Open-Laboratory/safeduino_mega_2560/kicad/safeduino_mega_2560.kicad_pcb

## KiCad design kicad/safeduino_mega_2560.kicad_pcb (2023-12-26)

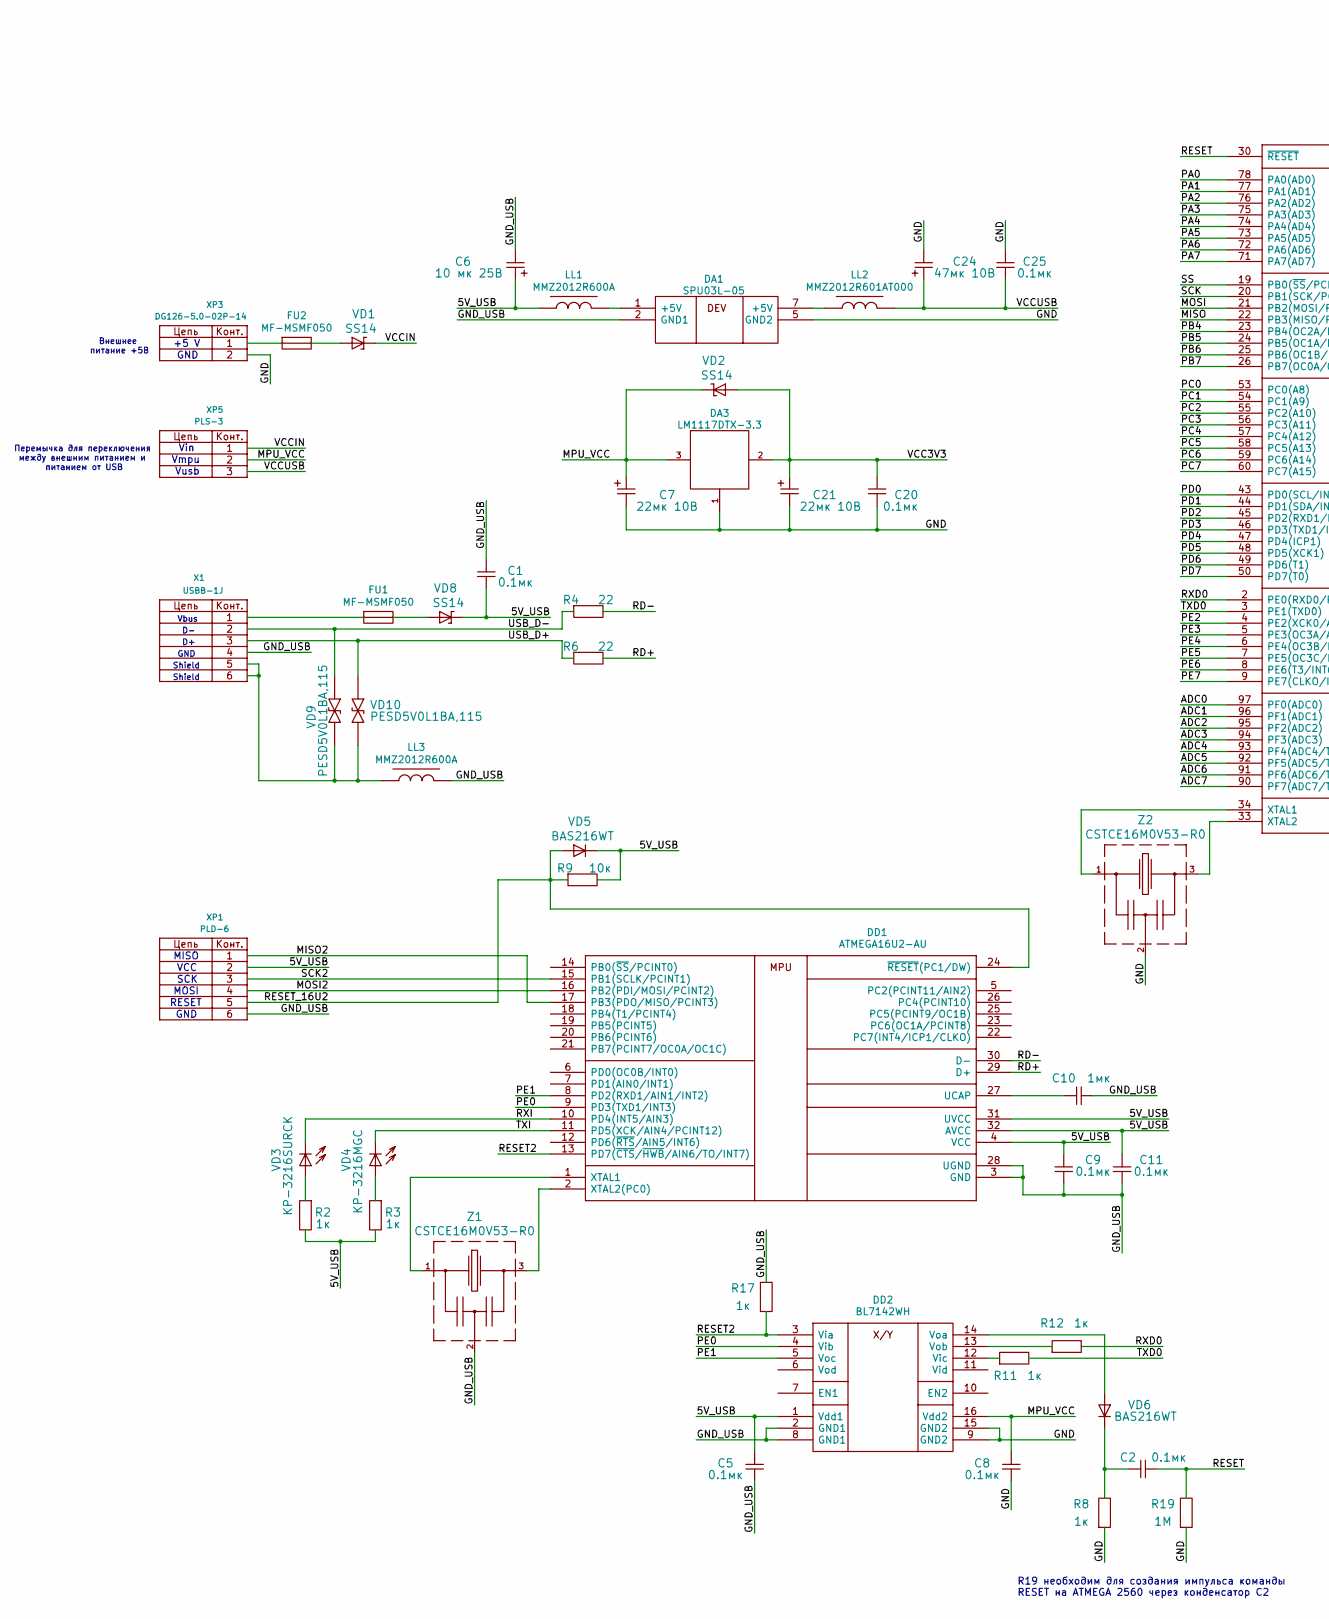
[picture p1: schematic safeduino_mega_2560.kicad_sch, SafeDuino MEGA 2560, part in row 1, column 1]

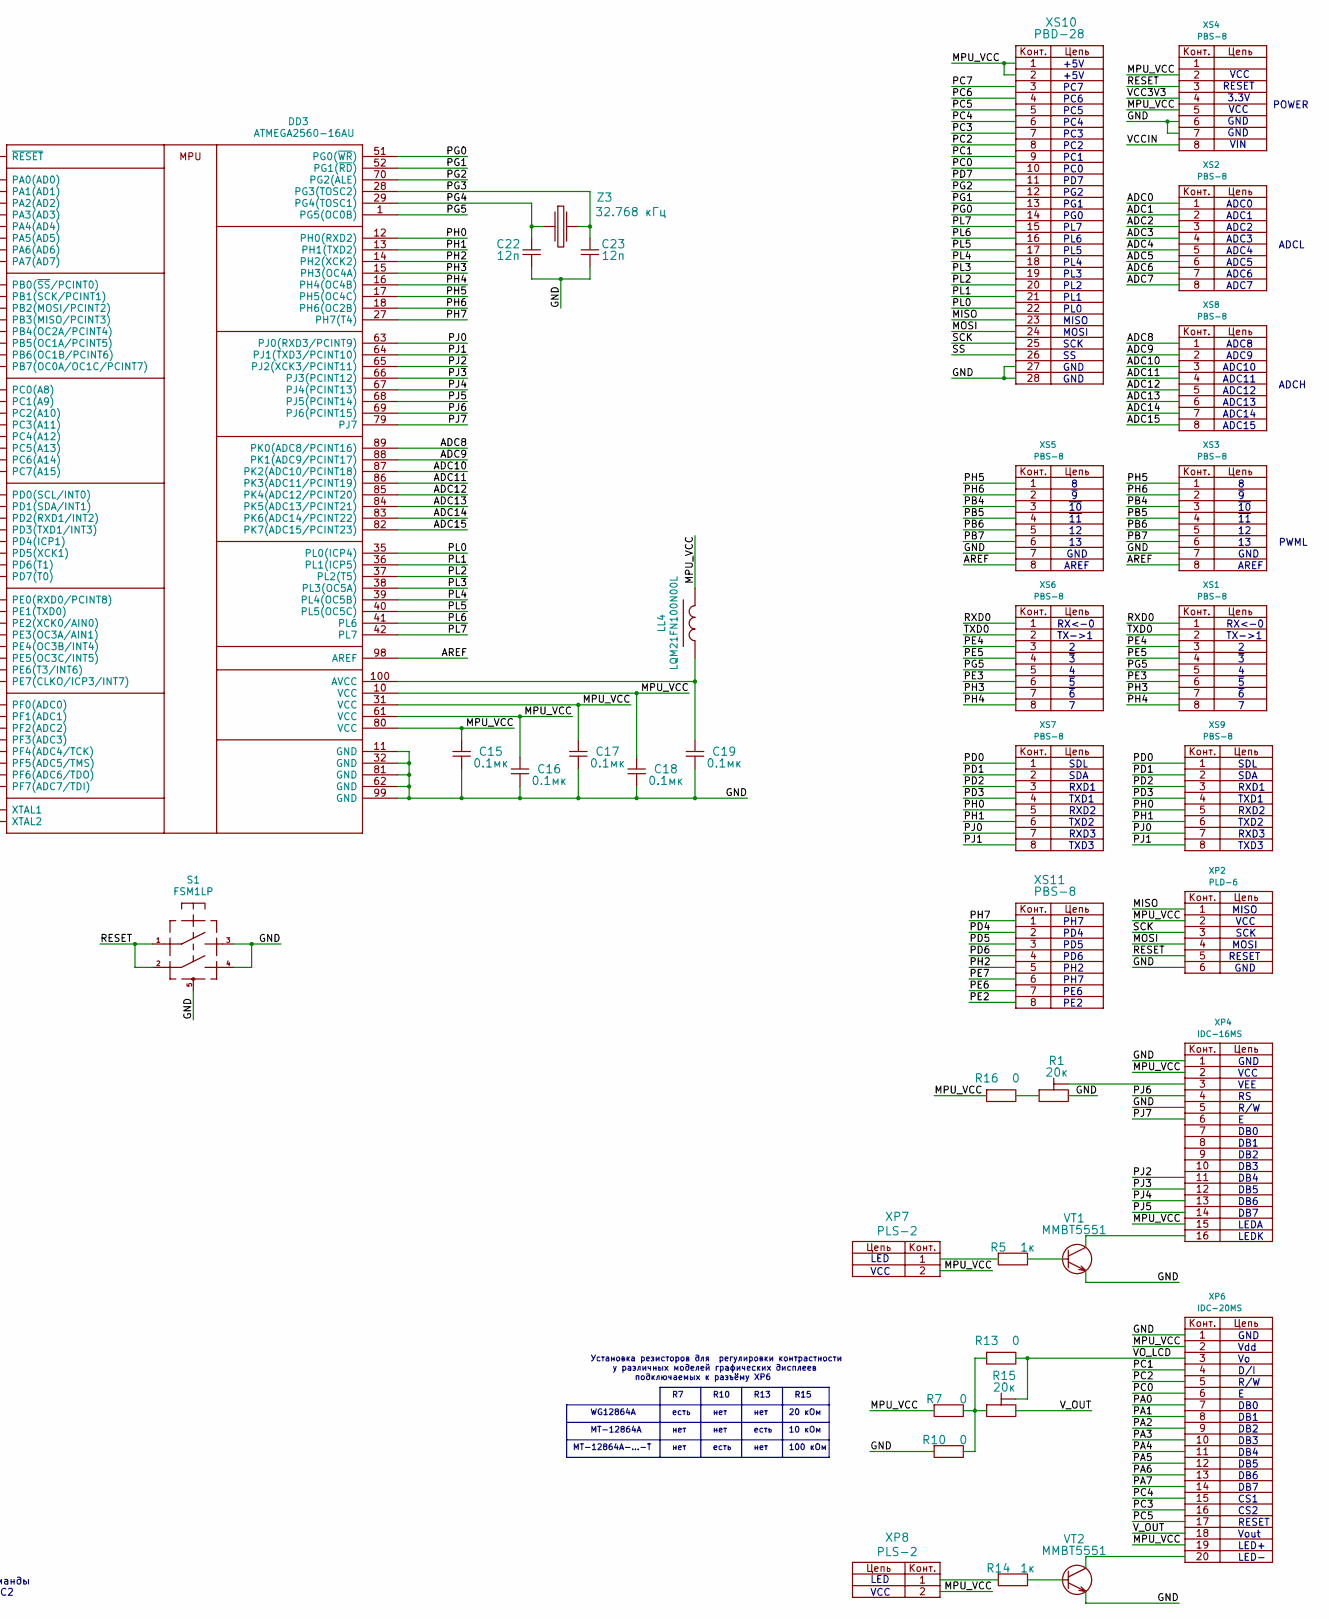
[picture p2: schematic safeduino_mega_2560.kicad_sch, SafeDuino MEGA 2560, part in row 1, column 2]

Parts:
C1, C2, C5, C8, C9, C11, C15, C16, C17, C18, C19, C20, C25: 0.1мк; SMD0603
C6: 10 мк 25В; CASE_C
C7, C21: 22мк 10В; CASE_B
C10: 1мк; SMD0805
C22, C23: 12п; SMD0603
C24: 47мк 10В; CASE_C
DA1: SPU03L-05; SIP-7_4pin
DA3: LM1117DTX-3.3; TO_252
DD1: ATMEGA16U2-AU; TQFP32_case
DD2: BL7142WH; SOIC16_RW16
DD3: ATMEGA2560-16AU; TQFP100_case
FU1, FU2: MF-MSMF050; SMD1812
LL1, LL3: MMZ2012R600A; SMD0805
LL2: MMZ2012R601AT000; SMD0805
LL4: LQM21FN100N00L; SMD0805
R1, R15: 20к; Electron_3296W
R2, R3, R5, R8, R11, R12, R14, R17: 1к; SMD0603
R4, R6: 22; SMD0603
R7, R10, R13, R16: 0; SMD0603
R9: 10к; SMD0603
R19: 1M; SMD0603
S1: FSM1LP; SWD_BUTTON
VD1, VD2, VD8: SS14; SMA
VD3: KP-3216SURCK; LED1206
VD4: KP-3216MGC; LED1206
VD5, VD6: BAS216WT; SOD523
VD9, VD10: PESD5V0L1BA,115; SOD323
VT1, VT2: MMBT5551; SOT_23
X1: USBB-1J; CONN_USB-B
XP1, XP2: PLD-6; PIN_ARRAY_3x2
XP3: DG126-5.0-02P-14
XP4: IDC-16MS
XP5: PLS-3; PIN_ARRAY_3x1
XP6: IDC-20MS
XP7, XP8: PLS-2; PIN_ARRAY_2x1
XS1, XS2, XS3, XS4, XS5, XS6, XS7, XS8, XS9, XS11: PBS-8; PIN_ARRAY_8x1
XS10: PBD-28; PIN_ARRAY_14x2
Z1, Z2: CSTCE16M0V53-R0; CSTNE_G_8-13_99MHz
Z3: 32.768 кГц; SMD0301M2-2

Connections:
/5V_USB: C1.1, C5.2, C6.1, C9.2, C11.2, DD1.4 (VCC), DD1.31 (UVCC), DD1.32 (AVCC), DD2.1 (Vdd1), LL1.2, R2.2, R3.2, R9.2, VD5.2, VD8.2, XP1.2
/ADC0: DD3.97 (PF0(ADC0)), XS2.1
/ADC1: DD3.96 (PF1(ADC1)), XS2.2
/ADC2: DD3.95 (PF2(ADC2)), XS2.3
/ADC3: DD3.94 (PF3(ADC3)), XS2.4
/ADC4: DD3.93 (PF4(ADC4/TCK)), XS2.5
/ADC5: DD3.92 (PF5(ADC5/TMS)), XS2.6
/ADC6: DD3.91 (PF6(ADC6/TDO)), XS2.7
/ADC7: DD3.90 (PF7(ADC7/TDI)), XS2.8
/ADC8: DD3.89 (PK0(ADC8/PCINT16)), XS8.1
/ADC9: DD3.88 (PK1(ADC9/PCINT17)), XS8.2
/ADC10: DD3.87 (PK2(ADC10/PCINT18)), XS8.3
/ADC11: DD3.86 (PK3(ADC11/PCINT19)), XS8.4
/ADC12: DD3.85 (PK4(ADC12/PCINT20)), XS8.5
/ADC13: DD3.84 (PK5(ADC13/PCINT21)), XS8.6
/ADC14: DD3.83 (PK6(ADC14/PCINT22)), XS8.7
/ADC15: DD3.82 (PK7(ADC15/PCINT23)), XS8.8
/AREF: DD3.98 (AREF), XS3.8, XS5.8
/GND: C7.2, C8.1, C15.2, C16.2, C17.2, C18.2, C19.2, C20.2, C21.2, C22.2, C23.2, C24.2, C25.2, DA1.5 (GND2), DA3.1 (com), DD2.9 (GND2), DD2.15 (GND2), DD3.11 (GND), DD3.32 (GND), DD3.62 (GND), DD3.81 (GND), DD3.99 (GND), R1.3, R8.1, R10.1, R19.1, S1.3, S1.4, S1.5, VT1.1, VT2.1, XP2.6, XP3.2, XP4.1, XP4.5, XP6.1, XS3.7, XS4.6, XS4.7, XS5.7, XS10.27, XS10.28, Z2.2
/GND_USB: C1.2, C5.1, C6.2, C9.1, C10.1, C11.1, DA1.2 (GND1), DD1.3 (GND), DD1.28 (UGND), DD2.2 (GND1), DD2.8 (GND1), LL3.1, R17.2, X1.4, XP1.6, Z1.2
/MISO: DD3.22 (PB3(MISO/PCINT3)), XP2.1, XS10.23
/MISO2: DD1.17 (PB3(PDO/MISO/PCINT3)), XP1.1
/MOSI: DD3.21 (PB2(MOSI/PCINT2)), XP2.4, XS10.24
/MOSI2: DD1.16 (PB2(PDI/MOSI/PCINT2)), XP1.4
/MPU_VCC: C7.1, C8.2, C15.1, C16.1, C17.1, C18.1, DA3.3 (Vin), DD2.16 (Vdd2), DD3.10 (VCC), DD3.31 (VCC), DD3.61 (VCC), DD3.80 (VCC), LL4.1, R7.1, R16.1, VD2.2, XP2.2, XP4.2, XP4.15, XP5.2, XP6.2, XP6.19, XP7.2, XP8.2, XS4.2, XS4.5, XS10.1, XS10.2
/PA0: DD3.78 (PA0(AD0)), XP6.7
/PA1: DD3.77 (PA1(AD1)), XP6.8
/PA2: DD3.76 (PA2(AD2)), XP6.9
/PA3: DD3.75 (PA3(AD3)), XP6.10
/PA4: DD3.74 (PA4(AD4)), XP6.11
/PA5: DD3.73 (PA5(AD5)), XP6.12
/PA6: DD3.72 (PA6(AD6)), XP6.13
/PA7: DD3.71 (PA7(AD7)), XP6.14
/PB4: DD3.23 (PB4(OC2A/PCINT4)), XS3.3, XS5.3
/PB5: DD3.24 (PB5(OC1A/PCINT5)), XS3.4, XS5.4
/PB6: DD3.25 (PB6(OC1B/PCINT6)), XS3.5, XS5.5
/PB7: DD3.26 (PB7(OC0A/OC1C/PCINT7)), XS3.6, XS5.6
/PC0: DD3.53 (PC0(A8)), XP6.6, XS10.10
/PC1: DD3.54 (PC1(A9)), XP6.4, XS10.9
/PC2: DD3.55 (PC2(A10)), XP6.5, XS10.8
/PC3: DD3.56 (PC3(A11)), XP6.16, XS10.7
/PC4: DD3.57 (PC4(A12)), XP6.15, XS10.6
/PC5: DD3.58 (PC5(A13)), XP6.17, XS10.5
/PC6: DD3.59 (PC6(A14)), XS10.4
/PC7: DD3.60 (PC7(A15)), XS10.3
/PD0: DD3.43 (PD0(SCL/INT0)), XS7.1, XS9.1
/PD1: DD3.44 (PD1(SDA/INT1)), XS7.2, XS9.2
/PD2: DD3.45 (PD2(RXD1/INT2)), XS7.3, XS9.3
/PD3: DD3.46 (PD3(TXD1/INT3)), XS7.4, XS9.4
/PD4: DD3.47 (PD4(ICP1)), XS11.2
/PD5: DD3.48 (PD5(XCK1)), XS11.3
/PD6: DD3.49 (PD6(T1)), XS11.4
/PD7: DD3.50 (PD7(T0)), XS10.11
/PE0: DD1.9 (PD3(TXD1/INT3)), DD2.4 (Vib)
/PE1: DD1.8 (PD2(RXD1/AIN1/INT2)), DD2.5 (Voc)
/PE2: DD3.4 (PE2(XCK0/AIN0)), XS11.8
/PE3: DD3.5 (PE3(OC3A/AIN1)), XS1.6, XS6.6
/PE4: DD3.6 (PE4(OC3B/INT4)), XS1.3, XS6.3
/PE5: DD3.7 (PE5(OC3C/INT5)), XS1.4, XS6.4
/PE6: DD3.8 (PE6(T3/INT6)), XS11.7
/PE7: DD3.9 (PE7(CLKO/ICP3/INT7)), XS11.6
/PG0: DD3.51 (PG0(~WR)), XS10.14
/PG1: DD3.52 (PG1(~RD)), XS10.13
/PG2: DD3.70 (PG2(ALE)), XS10.12
/PG3: C23.1, DD3.28 (PG3(TOSC2)), Z3.2
/PG4: C22.1, DD3.29 (PG4(TOSC1)), Z3.1
/PG5: DD3.1 (PG5(OC0B)), XS1.5, XS6.5
/PH0: DD3.12 (PH0(RXD2)), XS7.5, XS9.5
/PH1: DD3.13 (PH1(TXD2)), XS7.6, XS9.6
/PH2: DD3.14 (PH2(XCK2)), XS11.5
/PH3: DD3.15 (PH3(OC4A)), XS1.7, XS6.7
/PH4: DD3.16 (PH4(OC4B)), XS1.8, XS6.8
/PH5: DD3.17 (PH5(OC4C)), XS3.1, XS5.1
/PH6: DD3.18 (PH6(OC2B)), XS3.2, XS5.2
/PH7: DD3.27 (PH7(T4)), XS11.1
/PJ0: DD3.63 (PJ0(RXD3/PCINT9)), XS7.7, XS9.7
/PJ1: DD3.64 (PJ1(TXD3/PCINT10)), XS7.8, XS9.8
/PJ2: DD3.65 (PJ2(XCK3/PCINT11)), XP4.11
/PJ3: DD3.66 (PJ3(PCINT12)), XP4.12
/PJ4: DD3.67 (PJ4(PCINT13)), XP4.13
/PJ5: DD3.68 (PJ5(PCINT14)), XP4.14
/PJ6: DD3.69 (PJ6(PCINT15)), XP4.4
/PJ7: DD3.79 (PJ7), XP4.6
/PL0: DD3.35 (PL0(ICP4)), XS10.22
/PL1: DD3.36 (PL1(ICP5)), XS10.21
/PL2: DD3.37 (PL2(T5)), XS10.20
/PL3: DD3.38 (PL3(OC5A)), XS10.19
/PL4: DD3.39 (PL4(OC5B)), XS10.18
/PL5: DD3.40 (PL5(OC5C)), XS10.17
/PL6: DD3.41 (PL6), XS10.16
/PL7: DD3.42 (PL7), XS10.15
/RD+: DD1.29 (D+), R6.2
/RD-: DD1.30 (D-), R4.2
/RESET: C2.1, DD3.30 (~RESET), R19.2, S1.1, S1.2, XP2.5, XS4.3
/RESET2: DD1.13 (PD7(~CTS/~HWB/AIN6/TO/INT7)), DD2.3 (Via), R17.1
/RESET_16U2: DD1.24 (~RESET(PC1/DW)), R9.1, VD5.1, XP1.5
/RXD0: DD3.2 (PE0(RXD0/PCINT8)), R12.2, XS1.1, XS6.1
/RXI: DD1.10 (PD4(INT5/AIN3)), VD3.2
/SCK: DD3.20 (PB1(SCK/PCINT1)), XP2.3, XS10.25
/SCK2: DD1.15 (PB1(SCLK/PCINT1)), XP1.3
/SS: DD3.19 (PB0(~SS/PCINT0)), XS10.26
/TXD0: DD3.3 (PE1(TXD0)), R11.2, XS1.2, XS6.2
/TXI: DD1.11 (PD5(XCK/AIN4/PCINT12)), VD4.2
/USB_D+: R6.1, VD10.1, X1.3
/USB_D-: R4.1, VD9.1, X1.2
/VCC3V3: C20.1, C21.1, DA3.2 (Vout), VD2.1, XS4.4
/VCCIN: VD1.2, XP5.1, XS4.8
/VCCUSB: C24.1, C25.1, LL2.1, XP5.3
/VO_LCD: R13.2, R15.2, XP6.3
/V_OUT: R15.3, XP6.18
unnamed: C2.2, R8.2, VD6.2
unnamed: DA1.1 (+5V), LL1.1
unnamed: DA1.7 (+5V), LL2.2
unnamed: C10.2, DD1.27 (UCAP)
unnamed: DD1.1 (XTAL1), Z1.1
unnamed: DD1.2 (XTAL2(PC0)), Z1.3
unnamed: DD2.12 (Vic), R11.1
unnamed: DD2.14 (Voa), VD6.1
unnamed: DD2.13 (Vob), R12.1
unnamed: C19.1, DD3.100 (AVCC), LL4.2
unnamed: DD3.34 (XTAL1), Z2.1
unnamed: DD3.33 (XTAL2), Z2.3
unnamed: FU1.1, X1.1
unnamed: FU1.2, VD8.1
unnamed: FU2.1, XP3.1
unnamed: FU2.2, VD1.1
unnamed: LL3.2, VD9.2, VD10.2, X1.5, X1.6
unnamed: R1.1, R16.2
unnamed: R1.2, XP4.3
unnamed: R2.1, VD3.1
unnamed: R3.1, VD4.1
unnamed: R5.1, XP7.1
unnamed: R5.2, VT1.2
unnamed: R7.2, R10.2, R13.1, R15.1
unnamed: R14.1, XP8.1
unnamed: R14.2, VT2.2
unnamed: VT1.3, XP4.16
unnamed: VT2.3, XP6.20

Notes on the sheet:
TXD3
DB4
PG1
PC7
RESET
MOSI
TXD1
Shield
POWER
GND
есть
VCC
~{10}
ADC10
PC5
ADC11
RXD3
+5 V
ADC2
PH2
PD7
DB2
ADC1
PG2
Внешнее питание +5В
D/I
ADC15
PH7
DB1
RXD2
CS1
LEDA
PL4
ADC5
ADC8
PWML
CS2
~{6}
Vout
SCK
~{3}
10 кОм
RXD1
Vusb
PD5
+5V
LED
ADCL
нет
PC6
PC1
AREF
R/W
RX<-0
PL3
DB0
DB6
DB5
TX->1
~{11}
TXD2
PL6
SDA
DB3
ADC9
LED+
R15
PL0
Vin
PE2
~{5}
ADC0
MISO
ADC7
MT-12864A-...-T
SDL
LED-
PL5
MT-12864A
ADC14
Установка резисторов для регулировки контрастности у различных моделей графических дисплеев подключаемых к разъёму XP6
Перемычка для переключения между внешним питанием и питанием от USB
ADC6
R10
Vdd
ADC4
~{9}
20 кОм
VEE
PL7
PC0
PC4
WG12864A
PL1
LEDK
PL2
PC3
VIN
ADCH
PG0
R19 необходим для создания импульса команды RESET на ATMEGA 2560 через конденсатор С2
PD4
Vmpu
PD6
DB7
ADC13
R13
100 кОм
PE6
ADC3
Vbus
PC2
ADC12
3.3V

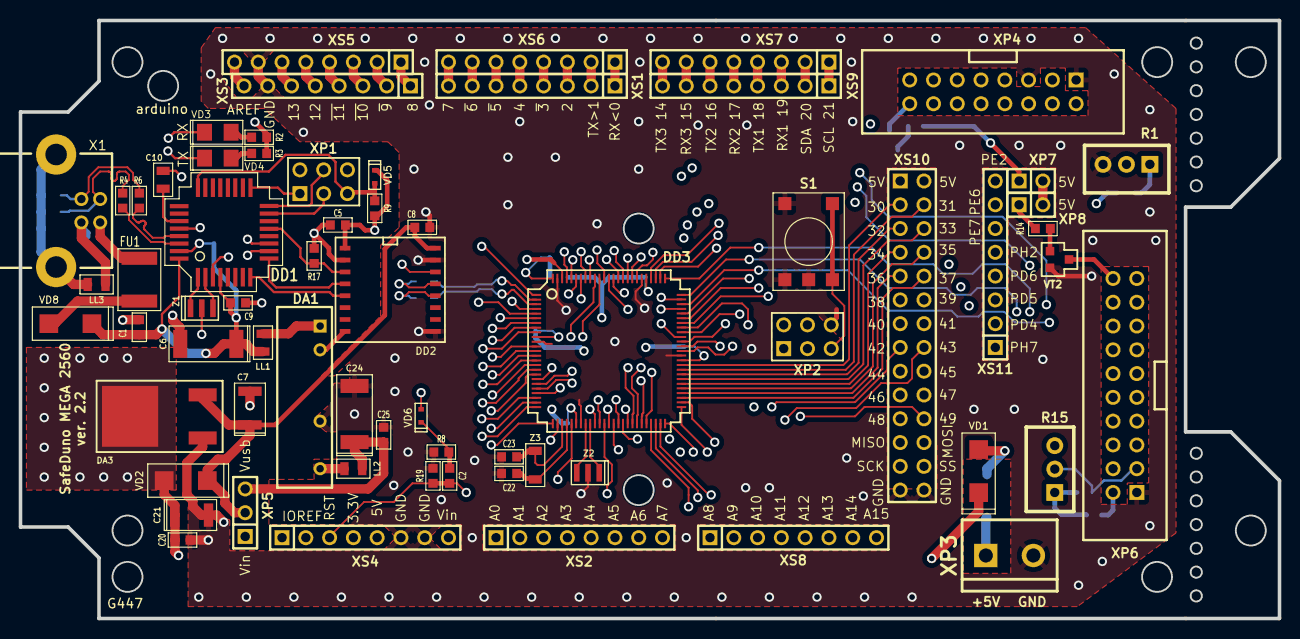
[picture p3: board safeduino_mega_2560.kicad_pcb from above]

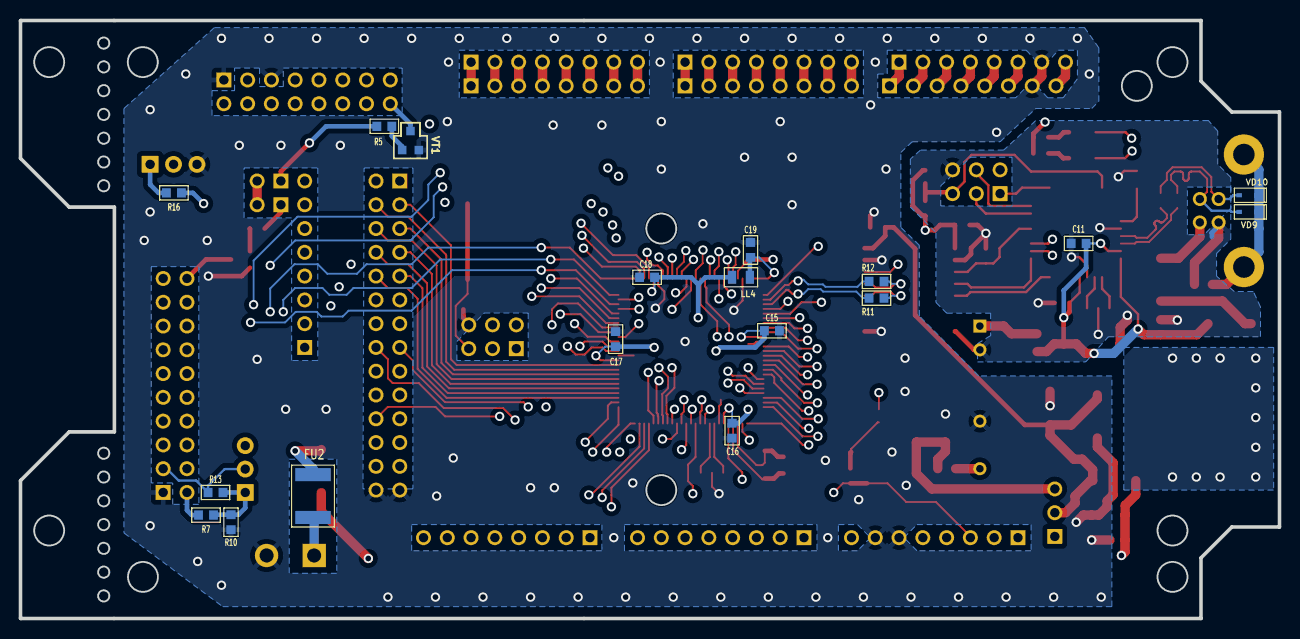
[picture p4: board safeduino_mega_2560.kicad_pcb from below]

Board: 4 copper layers, 134.5 x 63.9 mm, 84 parts (18 on the bottom side), 138 nets.
