Open-Laboratory/safeduino_mega_2560/(commit log)

2015-03-30 -aДобавил печатную плату SafeDuino MEGA 2560.
    [safeduino_mega_2560.kicad_pcb, safeduino_mega_2560.sch]
2015-03-30 added kicad components
2015-04-06 Исправил ошибку в подключении ADUM1301.
    [safeduino_mega_2560.kicad_pcb, safeduino_mega_2560.sch]
2015-04-15 Исправил ошибку с сигналом RESER.
    [safeduino_mega_2560.kicad_pcb, safeduino_mega_2560.sch]
2015-04-16 Услучшил разводку платы SafeDuino MEGA 2560.
    [safeduino_mega_2560.kicad_pcb, safeduino_mega_2560.sch]
2015-04-24 Поправил ошибку с перевёрнутым разъёмом.
    [safeduino_mega_2560.kicad_pcb]
2015-10-08 Исправил неточности в схеме.
    [safeduino_mega_2560.kicad_pcb, safeduino_mega_2560.sch]
2015-11-05 Поправил шелкографию и посадочное место для кнопки Reset.
    [safeduino_mega_2560.kicad_pcb]
2016-03-10 Заменил резистор R16 на диод для защиты ADUM от попадания напряжения на входную ногу.
    [safeduino_mega_2560.kicad_pcb, safeduino_mega_2560.sch]
2021-09-09 Приступил к разработке новой ревизии платы SafeDuino MEGA 2560 ver. 1.1.
    [safeduino_mega_2560.kicad_pcb, safeduino_mega_2560.sch]
2021-09-09 Удалил из проекта лишние файлы.
2021-09-13 Продолжил переделывать проект.
    [safeduino_mega_2560.kicad_pcb, safeduino_mega_2560.sch]
2022-11-17 Приступил к переработке платы SafeDuino MEGA 2560.
    [safeduino_mega_2560.kicad_pcb, safeduino_mega_2560.sch]
2022-11-18 Продолжил переделывать SafeDuino MEGA 2560.
    [safeduino_mega_2560.kicad_pcb, safeduino_mega_2560.sch]
2022-12-06 Продолжил переделывать печатную плату SafeDuino MEGA 2560.
    [safeduino_mega_2560.kicad_pcb, safeduino_mega_2560.sch]
2022-12-09 Продолжил трассировку печатной платы SafeDuino MEGA 2560.
    [safeduino_mega_2560.kicad_pcb]
2022-12-12 Закончил предварительную трассировку платы SafeDuino MEGA 2560.
    [safeduino_mega_2560.kicad_pcb, safeduino_mega_2560.sch]
2022-12-13 Оптимизировал трассировку печатной платы.
    [safeduino_mega_2560.kicad_pcb, safeduino_mega_2560.sch]
2022-12-14 Продолжил оптимизацию трассировки печатной платы.
    [safeduino_mega_2560.kicad_pcb, safeduino_mega_2560.sch]
2022-12-15 Поправил схему для лучшей защиты от ЭМП и продолжил переделывать трассировку печатной платы.
    [safeduino_mega_2560.kicad_pcb, safeduino_mega_2560.sch]
2022-12-16 Продолжил оптимизировать трассировку печатной платы.
    [safeduino_mega_2560.kicad_pcb, safeduino_mega_2560.sch]
2022-12-22 Закончил предварительную трассировку платы.
    [safeduino_mega_2560.kicad_pcb, safeduino_mega_2560.sch]
2022-12-23 Добавил в схему различные варианты подключения резистора регулировки контрастности для графического дисплея.
    [safeduino_mega_2560.kicad_pcb, safeduino_mega_2560.sch]
2023-01-18 Сохранил проект печатной платы в KiCad 6.0.2. и исправил недочёты в трассировке.
    [safeduino_mega_2560.kicad_pcb]
2023-01-23 Убрал старые версии файлов и добавил новые для Kicad 6.0.2.
    [safeduino_mega_2560.kicad_pcb, safeduino_mega_2560.kicad_sch, safeduino_mega_2560.sch]
2023-02-06 Добавил схему BL7142WH для сравнения с ADUM1301.
    [safeduino_mega_2560.kicad_sch]
2023-02-07 Заменил посадочные места на SOD523 у VD5 и VD6.
    [safeduino_mega_2560.kicad_pcb, safeduino_mega_2560.kicad_sch]
2023-02-22 Отправил печатную плату в производство.
    [safeduino_mega_2560.kicad_pcb]
2023-02-28 Добавил в файл с настройками (*.kicad_prl).
    [safeduino_mega_2560.kicad_pcb]
2023-06-15 Поправил ошибку с размерами разъёма USB-B и расположение компонентов около него, которые могли вызвать КЗ.
    [safeduino_mega_2560.kicad_pcb]
2023-12-26 Перевёл проект SafeDuino MEGA 2560 на Kicad 7.0 и поправил найденные недочёты на печатной плате.
    [safeduino_mega_2560.kicad_pcb, safeduino_mega_2560.kicad_sch]
